DLWILLIAMS99/Powercore-V3/quote/boost-converter-module/bom-quote.csv

Designator | Footprint | Quantity | Value | LCSC Part # | Manufacturer | Manufacturer Part Number | Distributor Part Number | Quote status | Notes
C1, C2, C3, C4, C6, C7, C8, C9 | 1206 | 8 | 10 uF | C96600 | Samsung Electro-Mechanics | CL31A106MBHNNNE | 1276-6736-1-ND | Existing mapping | Existing catalog mapping; supplier must confirm exact MPN and availability.
C10, C5 | 0603 | 2 | 1 uF | C106215 | YAGEO | CC0603KRX5R7BB105 | 311-1444-1-ND | Existing mapping | Existing catalog mapping; supplier must confirm exact MPN and availability.
C11 | 0805 | 1 | 33 uF | C342635 | TDK Corporation | C2012X5R1A336MTJ00E | 445-8238-1-ND | Existing mapping | Existing catalog mapping; supplier must confirm exact MPN and availability.
C12 | 0603 | 1 | 39nF | C107091 | YAGEO | CC0603KRX7R9BB393 | 311-3551-1-ND | Existing mapping | Existing catalog mapping; supplier must confirm exact MPN and availability.
C14 | 226TTA350M | 1 | 22UF | C6077372 | Cornell Dubilier Knowles | 226TTA350M | 1572-1694-ND | Existing mapping | Existing catalog mapping; supplier must confirm exact MPN and availability.
C15, C16 | 2220 | 2 | 2.2 uF | C445674 | TDK Corporation | C5750X6S2W225KT000N | 445-7781-1-ND | Existing mapping | Manufacturer field repaired from TDK Corporation to C5750X6S2W225KT000N. Catalog mapping C445674; confirm orderable suffix.
D1 | D_SMA | 1 | US1M-13-F | C99333 | Diodes Incorporated | US1M-13-F | US1M-FDICT-ND | Existing mapping | Existing catalog mapping; supplier must confirm exact MPN and availability.
L1 | SRR1210-681M | 1 | 680 uH |  | Bourns Inc. | SRR1210-681M | SRR1210-681MCT-ND | Source by MPN | Quote exact manufacturer part; LCSC mapping not verified. Include sourcing/handling fees.
R1, R2, R3 | 0805 | 3 | 200K | C728645 | YAGEO | RT0805BRD07200KL | YAG3357CT-ND | Existing mapping | Existing catalog mapping; supplier must confirm exact MPN and availability.
R4, R5 | 0603 | 2 | 2.2K | C3032396 | YAGEO | RC0603FR-132K2L | 13-RC0603FR-132K2LCT-ND | Existing mapping | Existing catalog mapping; supplier must confirm exact MPN and availability.
R6 | 0603 | 1 | 49.3K | C861433 | YAGEO | RT0603BRD0749K3L | 13-RT0603BRD0749K3LCT-ND | Existing mapping | Manufacturer field aligned to existing distributor number and C861433: RT0603BRD0749K3L, 49.3k, 0.1%, 0603.
R7 | 0603 | 1 | 15K | C855633 | YAGEO | AT0603BRD0715KL | YAG4139CT-ND | Existing mapping | Existing catalog mapping; supplier must confirm exact MPN and availability.
R8 | 0603 | 1 | 100K | C844916 | Vishay Intertech | CRCW0603100KFKEA | 541-100KHCT-ND | Existing mapping | Existing catalog mapping; supplier must confirm exact MPN and availability.
R9 | 1206 | 1 | 90mR |  | YAGEO | RL1206FR-070R09L | 13-RL1206FR-070R09LCT-ND | Source by MPN | Upstream issue #3: remove disputed C375525 mapping. Retain original RL1206FR-070R09L, 90 milliohm, 1%, 0.25 W, 1206. No 50 milliohm substitution.
U1 | TPL0401B-10DCKR | 1 | TPL0401B-10DCKR | C2666599 | Texas Instruments | TPL0401B-10DCKR | 296-29677-1-ND | Existing mapping | Existing catalog mapping; supplier must confirm exact MPN and availability.
U2 | lm5156h | 1 | LM5156HPWPR | C2867852 | Texas Instruments | LM5156HPWPR | 296-LM5156HPWPRCT-ND | Existing mapping | Existing catalog mapping; supplier must confirm exact MPN and availability.
U3 | STN3N40K3 | 1 | STN3N40K3 | C128261 | STMicroelectronics | STN3N40K3 | 497-11222-1-ND | Existing mapping | Existing catalog mapping; supplier must confirm exact MPN and availability.
