DLWILLIAMS99/Powercore-V3/quote/power-management-module/bom-quote.csv

Designator | Footprint | Quantity | Value | LCSC Part # | Manufacturer | Manufacturer Part Number | Distributor Part Number | Quote status | Notes
C1 | 0603 | 1 | 1 uF | C106215 | YAGEO | CC0603KRX5R7BB105 | 311-1444-1-ND | Existing mapping | Existing catalog mapping; supplier must confirm exact MPN and availability.
C10, C11, C12, C13, C14, C15, C16, C17, C18, C19, C2, C20, C21, C22, C23, C24, C25, C26, C27, C28, C29, C3, C30, C31, C32, C33, C34, C35, C4, C5, C6, C7, C8, C9 | 1206 | 34 | 10 uF | C96600 | Samsung Electro-Mechanics | CL31A106MBHNNNE | 1276-6736-1-ND | Existing mapping | Existing catalog mapping; supplier must confirm exact MPN and availability.
D1 | D_SMC | 1 | SMCJ60A-E3/57T | C1975272 | Vishay General Semiconductor - Diodes Division | SMCJ60A-E3/57T | SMCJ60A-E3/57TGICT-ND | Existing mapping | Existing catalog mapping; supplier must confirm exact MPN and availability.
L1 | SRP1245A | 1 | 18uH | C5926042 | Bourns Inc. | SRP1245A-180M | SRP1245A-180MCT-ND | Existing mapping | Existing catalog mapping; supplier must confirm exact MPN and availability.
R1, R6, R7 | 0603 | 3 | 100K | C844916 | Vishay Intertech | CRCW0603100KFKEA | CRCW0603100KFKEA | Existing mapping | Existing catalog mapping; supplier must confirm exact MPN and availability.
R10, R13 | 2512 | 2 | 1R | C181756 | YAGEO | RC2512FK-071RL | YAG3391CT-ND | Existing mapping | Existing catalog mapping; supplier must confirm exact MPN and availability.
R2, R3, R4, R5 | 0603 | 4 | 2.2K | C114662 | YAGEO | RC0603FR-132K2L | 13-RC0603FR-132K2LCT-ND | Existing mapping | Existing catalog mapping; supplier must confirm exact MPN and availability.
R8 | 0603 | 1 | 249R | C861249 | YAGEO | RT0603BRD07249RL | YAG1597CT-ND | Existing mapping | Existing catalog mapping; supplier must confirm exact MPN and availability.
R9 | 0603 | 1 | 0R | C95177 | YAGEO | RC0603JR-070RL | 311-0.0GRCT-ND | Existing mapping | Existing catalog mapping; supplier must confirm exact MPN and availability.
U1 | TPS1HTC30-Q1 | 1 | TPS1HTC30AQPWPRQ1 | C22414694 | Texas Instruments | TPS1HTC30AQPWPRQ1 | 296-TPS1HTC30AQPWPRQ1CT-ND | Existing mapping | Existing catalog mapping; supplier must confirm exact MPN and availability.
