DLWILLIAMS99/Powercore-V3/circuit-boards/dual-converter-boost-converter-module-V1.0/dual-converter-boost-converter-module-V1.0.kicad_pcb

## KiCad design circuit-boards/dual-converter-boost-converter-module-V1.0/dual-converter-boost-converter-module-V1.0.kicad_pcb (2026-10-26)

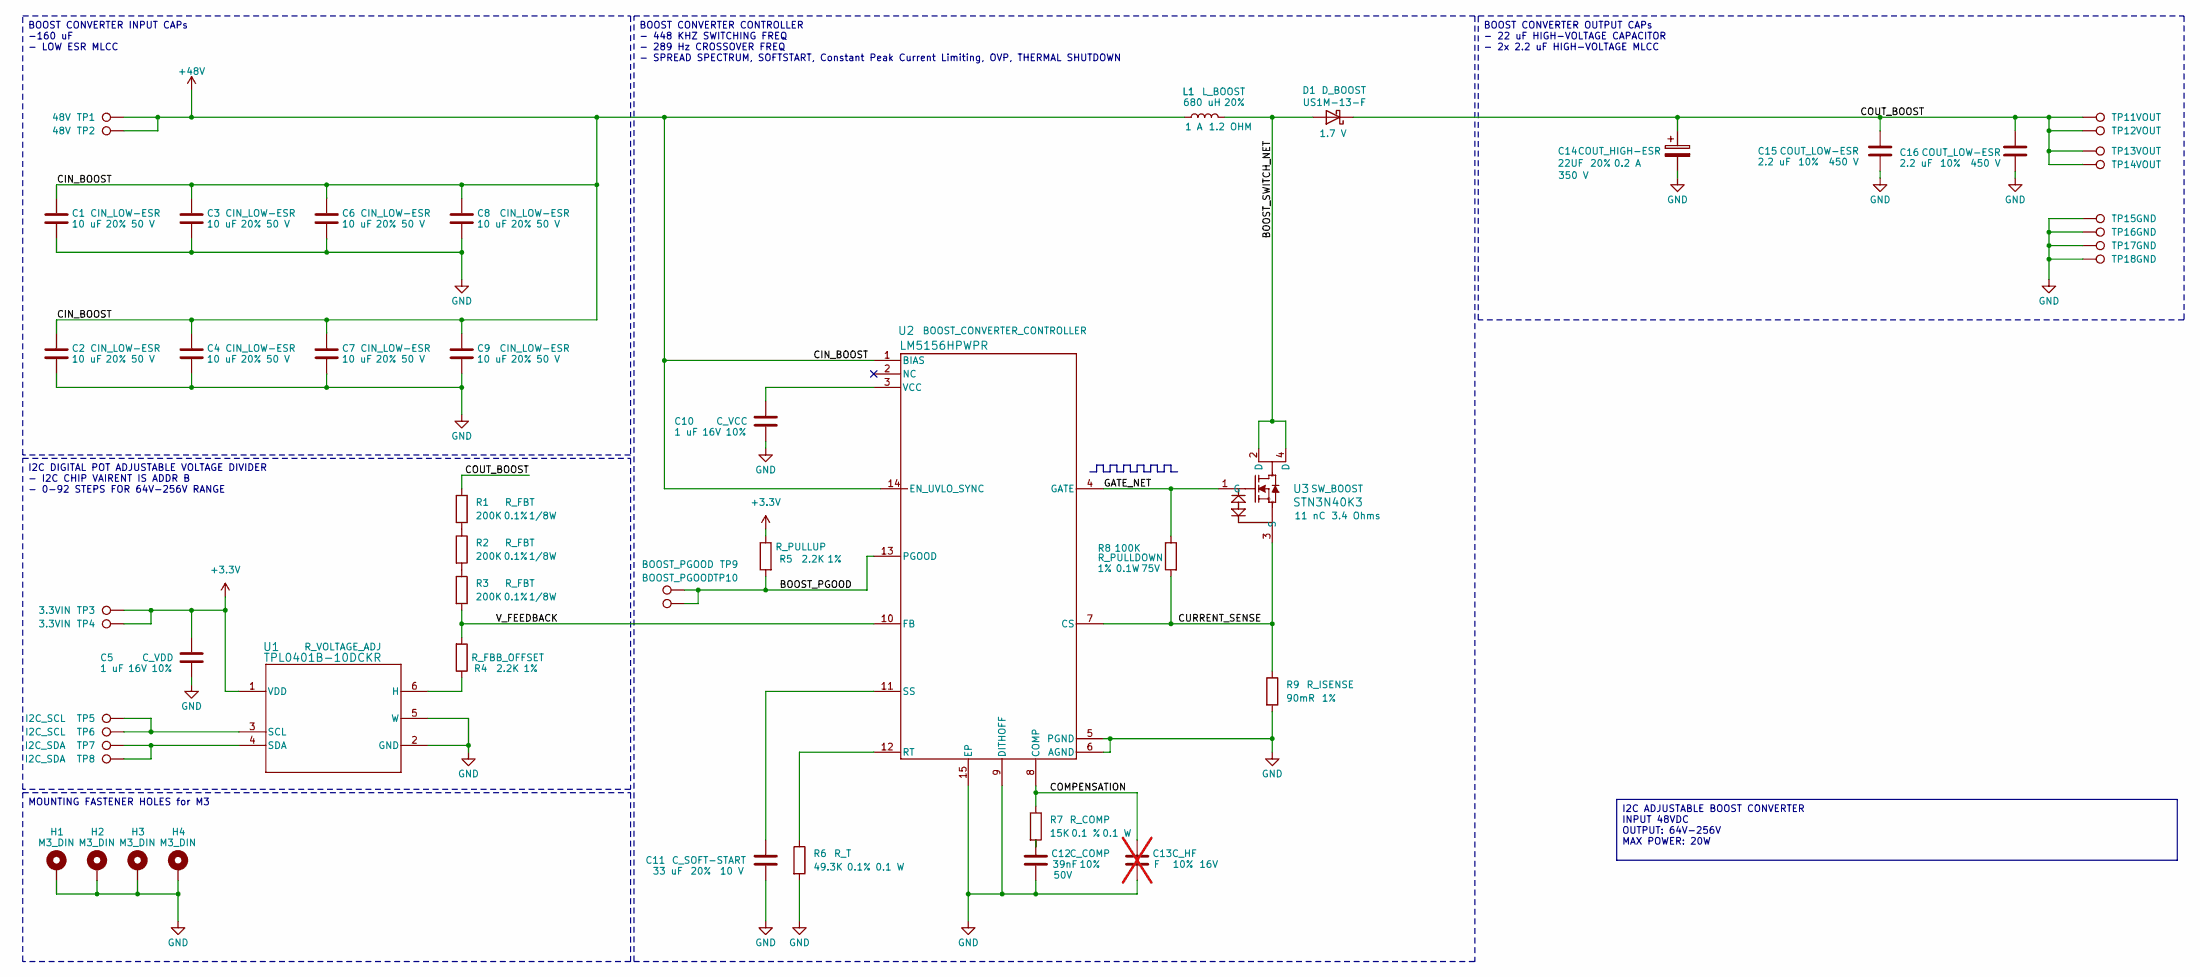
[picture p1: schematic dual-converter-boost-converter-module-V1.0.kicad_sch, Boost Converter Module]

Parts:
C1, C2, C3, C4, C6, C7, C8, C9: 10 uF; C_1206_3216Metric; Tolerance 20%; Max Voltage 50 V; Manufacturer# CL31A106MBHNNNE; LCSC Part # C96600
C5, C10: 1 uF; C_0603_1608Metric; Tolerance 10%; Max Voltage 16V; Manufacturer# CC0603KRX5R7BB105; LCSC Part # C106215
C11: 33 uF; C_0805_2012Metric; Tolerance 20%; Max Voltage 10 V; Manufacturer# C2012X5R1A336MTJ00E; LCSC Part # C342635
C12: 39nF; C_0603_1608Metric; Tolerance 10%; Max Voltage 50V; Manufacturer# CC0603KRX7R9BB393; LCSC Part # C107091
C13: F; C_0603_1608Metric; Tolerance 10%; Max Voltage 16V; Manufacturer# NULL; LCSC Part # NULL; not fitted
C14: 22UF; 226TTA350M; Tolerance 20%; Max Voltage 350 V; Manufacturer# 226TTA350M; LCSC Part # C6077372
C15, C16: 2.2 uF; C_2220_5750Metric; Tolerance 10%; Max Voltage 450 V; Manufacturer# C5750X6S2W225KT000N; LCSC Part # C445674
D1: US1M-13-F; D_SMA; Forward Voltage 1.7 V; Manufacturer# US1M-13-F; LCSC Part # C99333
H1, H2, H3, H4: M3_DIN; MountingHole_3.2mm_M3_DIN965_Pad_TopBottom; Manufacturer# NULL
L1: 680 uH; SRR1210-681M; Tolerance 20%; Manufacturer# SRR1210-681M; LCSC Part # NULL
R1, R2, R3: 200K; R_0805_2012Metric; Tolerance 0.1%; Manufacturer# RT0805BRD07200KL; LCSC Part # C728645
R4, R5: 2.2K; R_0603_1608Metric; Tolerance 1%; Manufacturer# RC0603FR-132K2L; LCSC Part # C3032396
R6: 49.3K; R_0603_1608Metric; Tolerance 0.1%; Manufacturer# RT0603BRD0749K3L; LCSC Part # C861433
R7: 15K; R_0603_1608Metric; Tolerance 0.1 %; Manufacturer# AT0603BRD0715KL; LCSC Part # C855633
R8: 100K; R_0603_1608Metric; Tolerance 1%; Max Voltage 75V; Manufacturer# CRCW0603100KFKEA; LCSC Part # C844916
R9: 90mR; R_1206_3216Metric; Tolerance 1%; Manufacturer# RL1206FR-070R09L
TP1, TP2: 48V; TestPoint_TestPoint_Pad_2.0x2.0mm_No_Silkscreen; Manufacturer# NULL
TP3, TP4: 3.3VIN; TestPoint_TestPoint_Pad_2.0x2.0mm_No_Silkscreen; Manufacturer# NULL
TP5, TP6: I2C_SCL; TestPoint_TestPoint_Pad_2.0x2.0mm_No_Silkscreen; Manufacturer# NULL
TP7, TP8: I2C_SDA; TestPoint_TestPoint_Pad_2.0x2.0mm_No_Silkscreen; Manufacturer# NULL
TP9, TP10: BOOST_PGOOD; TestPoint_TestPoint_Pad_2.0x2.0mm_No_Silkscreen; Manufacturer# NULL
TP11, TP12, TP13, TP14: VOUT; TestPoint_TestPoint_Pad_2.0x2.0mm_No_Silkscreen; Manufacturer# NULL
TP15, TP16, TP17, TP18: GND; TestPoint_TestPoint_Pad_2.0x2.0mm_No_Silkscreen; Manufacturer# NULL
U1: TPL0401B-10DCKR; Manufacturer# TPL0401B-10DCKR; LCSC Part # C2666599
U2: LM5156HPWPR; lm5156h; Manufacturer# LM5156HPWPR; LCSC Part # C2867852
U3: STN3N40K3; Manufacturer# STN3N40K3; LCSC Part # C128261

Connections:
+3.3V: C5.1, R5.1, TP3.1, TP4.1, U1.1 (VDD)
+48V: C1.1, C2.1, C3.1, C4.1, C6.1, C7.1, C8.1, C9.1, L1.1, TP1.1, TP2.1, U2.1 (BIAS), U2.14 (EN_UVLO_SYNC)
/BOOST_PGOOD: R5.2, TP9.1, TP10.1, U2.13 (PGOOD)
/BOOST_SWITCH_NET: D1.2 (A), L1.2, U3.2 (D), U3.4 (D)
/COMPENSATION: C13.1, R7.1, U2.8 (COMP)
/COUT_BOOST: C14.1, C15.1, C16.1, D1.1 (K), R1.1, TP11.1, TP12.1, TP13.1, TP14.1
/CURRENT_SENSE: R8.2, R9.1, U2.7 (CS), U3.3 (S)
/GATE_NET: R8.1, U2.4 (GATE), U3.1 (G)
/V_FEEDBACK: R3.2, R4.2, U2.10 (FB)
GND: C1.2, C2.2, C3.2, C4.2, C5.2, C6.2, C7.2, C8.2, C9.2, C10.2, C11.2, C12.2, C13.2, C14.2, C15.2, C16.2, H1.1, H2.1, H3.1, H4.1, R6.2, R9.2, TP15.1, TP16.1, TP17.1, TP18.1, U1.2 (GND), U1.5 (W), U2.5 (PGND), U2.6 (AGND), U2.9 (DITHOFF), U2.15 (EP)
unnamed: C12.1, R7.2
unnamed: R1.2, R2.1
unnamed: R2.2, R3.1
unnamed: R4.1, U1.6 (H)
unnamed: TP5.1, TP6.1, U1.3 (SCL)
unnamed: TP7.1, TP8.1, U1.4 (SDA)
unnamed: R6.1, U2.12 (RT)
unnamed: C11.1, U2.11 (SS)
unnamed: C10.1, U2.3 (VCC)

Notes on the sheet:
BOOST CONVERTER CONTROLLER - 448 KHZ SWITCHING FREQ - 289 Hz CROSSOVER FREQ - SPREAD SPECTRUM, SOFTSTART, Constant Peak Current Limiting, OVP, THERMAL SHUTDOWN
BOOST CONVERTER INPUT CAPs -160 uF - LOW ESR MLCC
I2C DIGITAL POT ADJUSTABLE VOLTAGE DIVIDER - I2C CHIP VAIRENT IS ADDR B - 0-92 STEPS FOR 64V-256V RANGE
MOUNTING FASTENER HOLES for M3
BOOST CONVERTER OUTPUT CAPs - 22 uF HIGH-VOLTAGE CAPACITOR - 2x 2.2 uF HIGH-VOLTAGE MLCC
I2C ADJUSTABLE BOOST CONVERTER INPUT 48VDC OUTPUT: 64V-256V MAX POWER: 20W

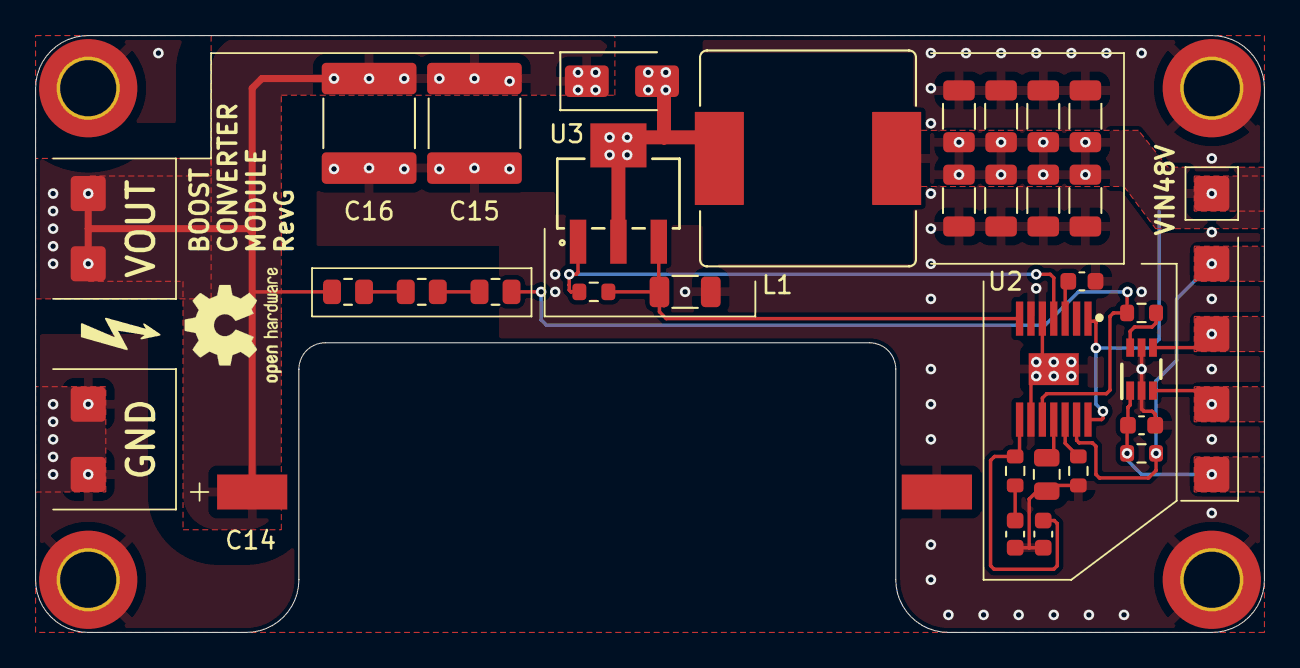
[picture p2: board dual-converter-boost-converter-module-V1.0.kicad_pcb from above]

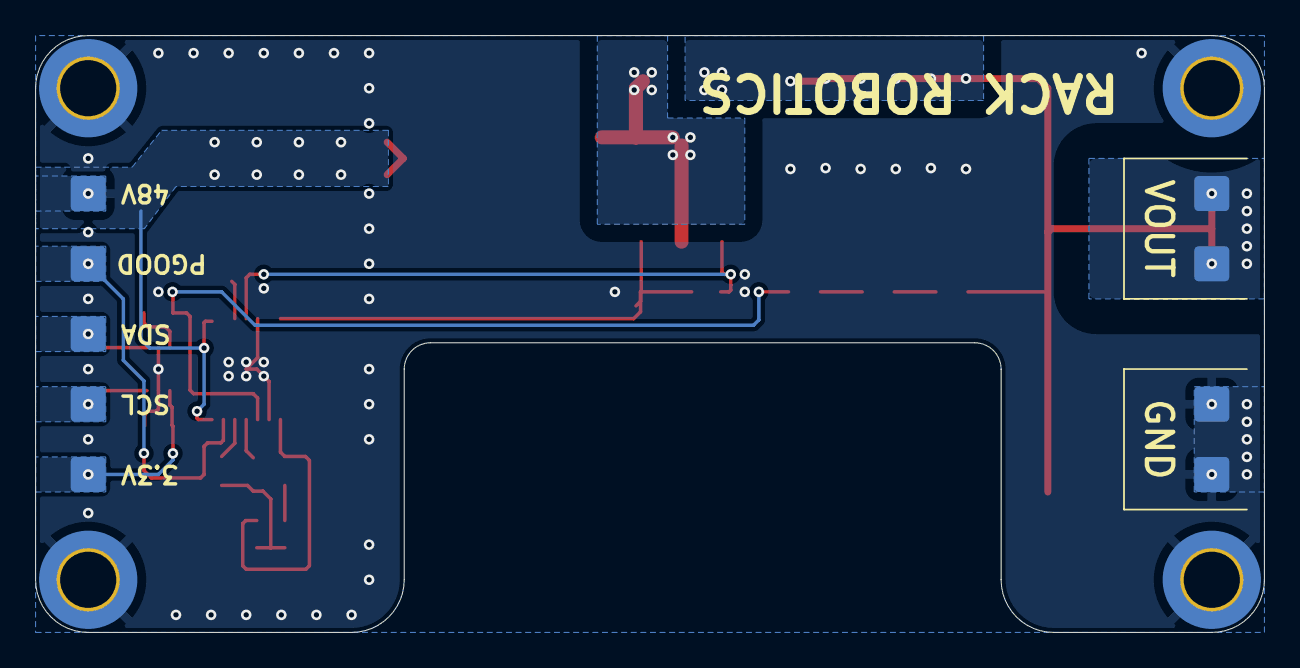
[picture p3: board dual-converter-boost-converter-module-V1.0.kicad_pcb from below]

Board: 4 copper layers, 70.0 x 34.0 mm, 52 parts (9 on the bottom side), 19 nets.
