DLWILLIAMS99/Powercore-V3/circuit-boards/dual-converter-motherboard-V1.0/dual-converter-motherboard-V1.0.kicad_pcb

## KiCad design circuit-boards/dual-converter-motherboard-V1.0/dual-converter-motherboard-V1.0.kicad_pcb (2026-10-26)

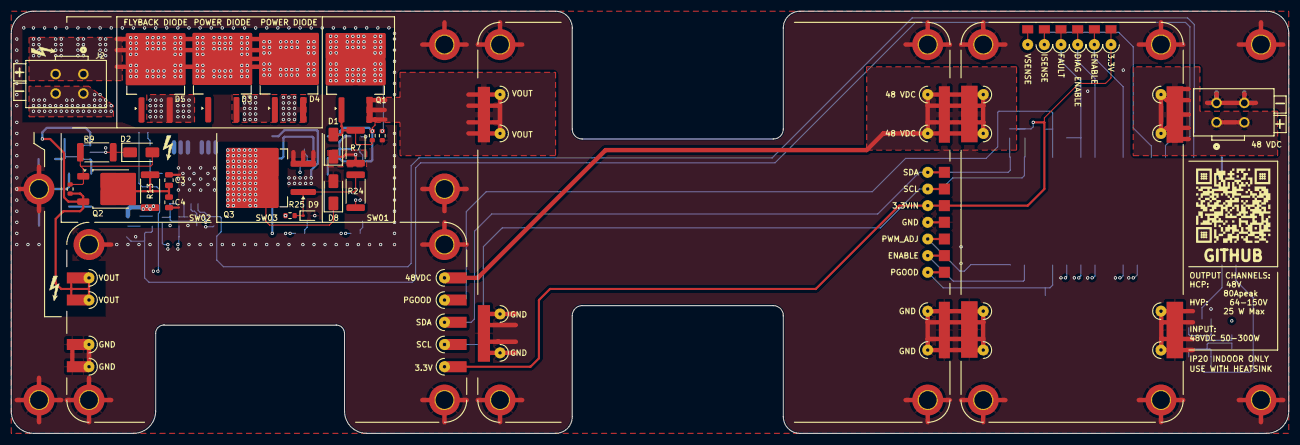
[picture p4: board dual-converter-motherboard-V1.0.kicad_pcb from above]

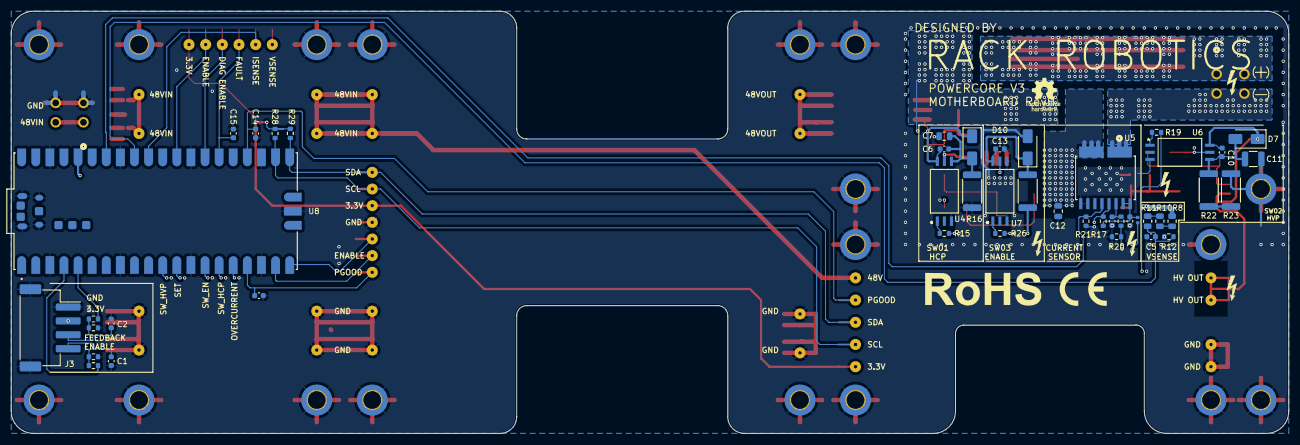
[picture p5: board dual-converter-motherboard-V1.0.kicad_pcb from below]

Board: 6 copper layers, 230.0 x 76.0 mm, 118 parts (45 on the bottom side), 49 nets.

Parts:
C1, C6, C8, C9, C10, C13: 220 nF; C_0603_1608Metric
C2, C14, C15, C16: 10000 pF; C_0603_1608Metric
C3, C4, C12: 10 nF; C_0805_2012Metric
C5: pF; C_0603_1608Metric
C7: 0.47 uF; C_0805_2012Metric
C11: 0.1 uF; C_1210_3225Metric
D1, D2, D8: US1M-13-F; D_SMA
D3, D4, D5: STPSC20065GY-TR
D6, D7, D10: D_Zener; D_SMA
D9: D_Zener; D_SOD-323
H1, H2, H3, H4, H5, H6, H7, H8, H9, H10, H11, H12, H13, H14, H15, H16, H17, H18: M3_DIN; MountingHole_3.2mm_M3_DIN965_Pad_TopBottom
J1, J2: 2601-1102
J3: S4B-XH-SM4-TB
L1: BBUP00100505330Y00; L_0402_1005Metric
POGO1, POGO2, POGO3, POGO4, POGO5, POGO6, POGO7, POGO8, POGO9, POGO10, POGO11, POGO12, POGO13, POGO14, POGO15, POGO16, POGO17, POGO18, POGO19, POGO20, POGO21, POGO22, POGO23, POGO24, POGO25, POGO26, POGO27, POGO28, POGO29, POGO30: 0906-8-15-20-76-14-11-0
Q1: SUM110P08-11L-E3
Q2: DMP45H4D9HK3-13
Q3: SIHB068N60EF-GE3; TO-263-2
R1, R2: 1K; R_0603_1608Metric
R3, R4, R12, R14, R17, R20, R21, R25: 10K; R_0603_1608Metric
R5, R6: 255K; R_0603_1608Metric
R7, R9, R24: 10R; R_2512_6332Metric
R8, R10, R11: 332K; R_0805_2012Metric
R13: 1R; R_2512_6332Metric
R15, R19, R26: 100R; R_0603_1608Metric
R16, R27: 1K; R_2512_6332Metric
R18, R28, R29: 2.2K; R_0603_1608Metric
R22, R23: 12K; R_2512_6332Metric
U1: POWER_MANAGEMENT_MODULE; POWER_MANAGEMENT_MODULE_FOOTPRINT_V1.0
U2: HIGH-CURRENT_PHASE_MODULE_V1.0; HIGH-CURRENT_PHASE_MODULE_FOOTPRINT_V1.0
U3: HIGH-VOLTAGE_PHASE_MODULE; HIGH-VOLTAGE_PHASE_MODULE_FOOTPRINT_V1.0
U4, U6, U7: UCC23313BDWYR
U5: TMCS1133C1A; TMCS1133C3AQDVGR
U8: SC0915

Connections:
+3.3V: J3.2, L1.2, R28.2, R29.2, U1.5, U2.8 (3.3VIN), U3.3 (GND), U8.36 (3V3_OUT)
+18V: C13.1, D10.1 (K), R27.1, U7.6 (VCC)
+48V: R27.2, U1.1 (VOUT), U2.11 (48VIN), U3.7 (48VIN)
/48VIN: J1.1 (1_1), J1.2 (1_2), U1.4 (VIN)
/BOOST-CONVERTER-OUTPUT: C10.1, D7.1 (K), Q2.3 (S), R6.1, U3.1 (VOUT), U6.6 (VCC)
/BOOST_PGOOD: C14.1, U3.6 (PGOOD), U8.24 (GP18)
/BUCK-CONVERTER-OUTPUT: C6.1, D6.1 (K), Q1.3 (S), R5.1, U2.1 (VOUT), U4.6 (VCC)
/BUCK_ADJ_PWM: U2.6 (PWM_ADJ), U8.20 (GP15)
/BUCK_ENABLE: U2.5 (ENABLE), U8.19 (GP14)
/BUCK_POWER_GOOD: C16.1, U2.4 (PGOOD), U8.17 (GP13)
/EDM_ELECTRODE(+): D3.1 (K), D4.1 (K), D5.1 (K), J2.1 (1_1), J2.2 (1_2), R8.1, R13.1
/EDM_ELECTRODE(-): D5.2 (A), J2.3 (2_1), J2.4 (2_2), U5.1 (IN+)
/I2C_SCL: R28.1, U2.9 (SCL), U3.4 (SCL), U8.22 (GP17)
/I2C_SDA: R29.1, U2.10 (SDA), U3.5 (SDA), U8.21 (GP16)
/PMM_DIAG_EN: U1.7, U8.27 (GP21)
/PMM_ENABLE: U1.6, U8.29 (GP22)
/PMM_FAULT: C15.1, U1.8, U8.26 (GP20)
/PMM_ISENSE: U1.9, U8.31 (GP26)
/controller/ADC1: C5.1, R11.2, R12.1, U8.32 (GP27)
/controller/ADC2: R21.1, U5.6 (VOUT), U8.34 (GP28)
/controller/EDM_ENABLE: R1.2, U8.4 (GP2)
/controller/EDM_FEEDBACK: R2.2, U8.5 (GP3)
/controller/OUTPUT_OVERCURRENT: R17.2, U5.7 (OC), U8.16 (GP12)
/controller/OUTPUT_OVERCURRENT_SET: R18.1, R20.1, U8.12 (GP9)
/controller/SW_ENABLE: R26.2, U8.14 (GP10)
/controller/SW_HIGH-CURRENT-PHASE: R15.2, U8.15 (GP11)
/controller/SW_HIGH-VOLTAGE-PHASE: R19.2, U8.11 (GP8)
/output-stage/SW01_GATE: D1.1 (K), R7.1, U4.5 (VOUT)
/output-stage/SW02_GATE: D2.1 (K), R9.1, U6.5 (VOUT)
/output-stage/SW03_GATE: R24.1, U7.5 (VOUT)
GND: C1.2, C2.2, C3.2, C4.2, C5.2, C7.2, C8.2, C9.2, C11.2, C12.2, C13.2, C14.2, C15.2, C16.2, D8.2 (A), D9.2 (A), D10.2 (A), H1.1, H2.1, H3.1, H4.1, H5.1, H6.1, H7.1, H8.1, H9.1, H10.1, H11.1, H12.1, H13.1, H14.1, H15.1, H16.1, H17.1, H18.1, J1.3 (2_1), J1.4 (2_2), J3.1, J3.MP, Q3.3 (S), R3.2, R4.2, R12.2, R14.2, R16.1, R20.2, R21.2, R23.2, R25.2, U1.2, U1.3, U2.2 (GND), U2.3 (GND), U2.7 (GND), U3.2 (GND), U4.3 (CATHODE), U5.3 (GND), U5.4 (ALERT), U6.3 (CATHODE), U7.3 (CATHODE), U7.4 (VEE), U8.3 (GND), U8.8 (GND__1), U8.13 (GND__2), U8.18 (GND__3), U8.23 (GND__4), U8.28 (GND__5), U8.33 (AGND), U8.38 (GND__6), U8.A (USB_SHIELD), U8.B (USB_SHIELD__1), U8.C (USB_SHIELD__2), U8.D (USB_SHIELD__3), U8.D2 (GND__7)
unnamed: C8.1, L1.1, R17.1, U5.9 (VS), U5.10 (VS)
unnamed: D1.2 (A), Q1.2 (G), R5.2, R7.2
unnamed: D2.2 (A), Q2.2 (G), R6.2, R9.2
unnamed: D3.2 (A), D4.2 (A), Q1.1 (D), R14.1
unnamed: C6.2, C7.1, D6.2 (A), R16.2, U4.4 (VEE)
unnamed: C10.2, C11.1, D7.2 (A), R22.1, U6.4 (VEE)
unnamed: C12.1, D8.1 (K), Q3.2 (D), U5.2 (IN-)
unnamed: D9.1 (K), Q3.1 (G), R24.2, R25.1
unnamed: C2.1, J3.3, R2.1, R4.1
unnamed: C1.1, J3.4, R1.1, R3.1
unnamed: C3.1, C4.1, Q2.1 (D), R13.2
unnamed: R8.2, R10.1
unnamed: R10.2, R11.1
unnamed: R22.2, R23.1
unnamed: R15.1, U4.1 (ANODE)
unnamed: C9.1, R18.2, U5.8 (VOC)
unnamed: R19.1, U6.1 (ANODE)
unnamed: R26.1, U7.1 (ANODE)
