DLWILLIAMS99/Powercore-V3/(commit log)

2026-07-09 Flag unresolved boost module R9 part mapping
    [bom.csv]
2026-07-09 Add engineering review notes for EDM power stage concerns
2026-10-26 Reconcile procurement BOMs and prepare four-board quotation package
    [bom-quote.csv, bom.csv, dual-converter-boost-converter-module-V1.0.kicad_pcb, dual-converter-boost-converter-module-V1.0.kicad_sch, dual-converter-motherboard-V1.0.kicad_pcb, output-stage.kicad_sch, positions.csv]
